pacman314159/Multipurpose_ESP32_Gamepad/imgs/internal assembly (2).png

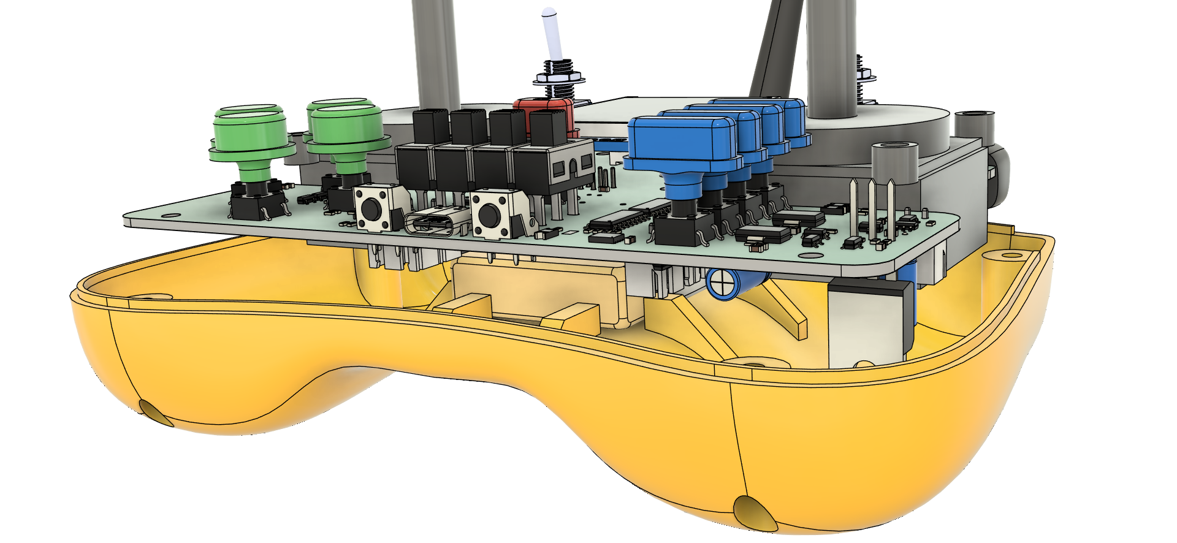
imgs/internal assembly (2).png
