pacman314159/Multipurpose_ESP32_Gamepad/imgs/3d design.png

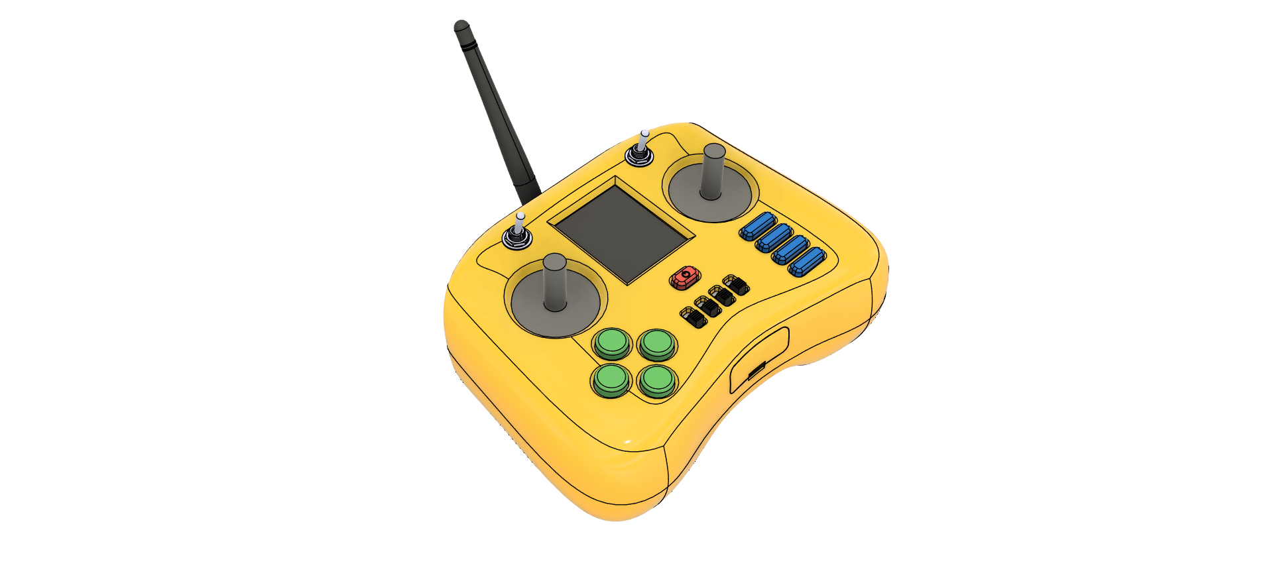
imgs/3d design.png
