pacman314159/Multipurpose_ESP32_Gamepad/imgs/pcb 3d (1).png

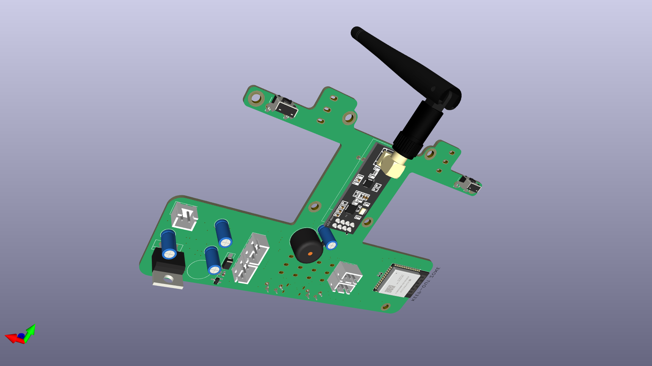
imgs/pcb 3d (1).png
