pacman314159/Multipurpose_ESP32_Gamepad/imgs/pcb 3d.png

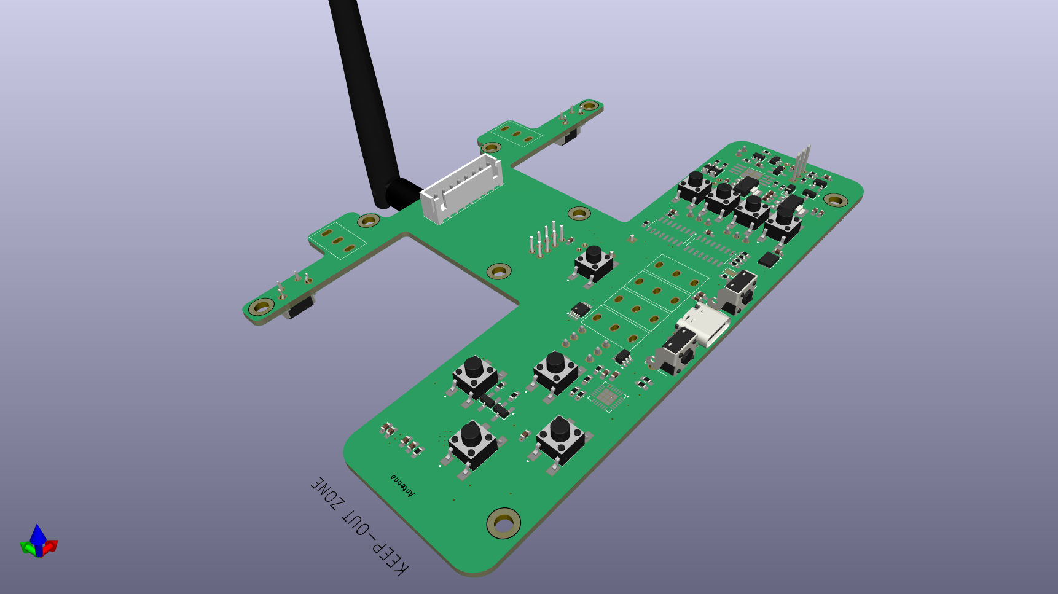
imgs/pcb 3d.png
