pacman314159/Multipurpose_ESP32_Gamepad/imgs/pcb.png

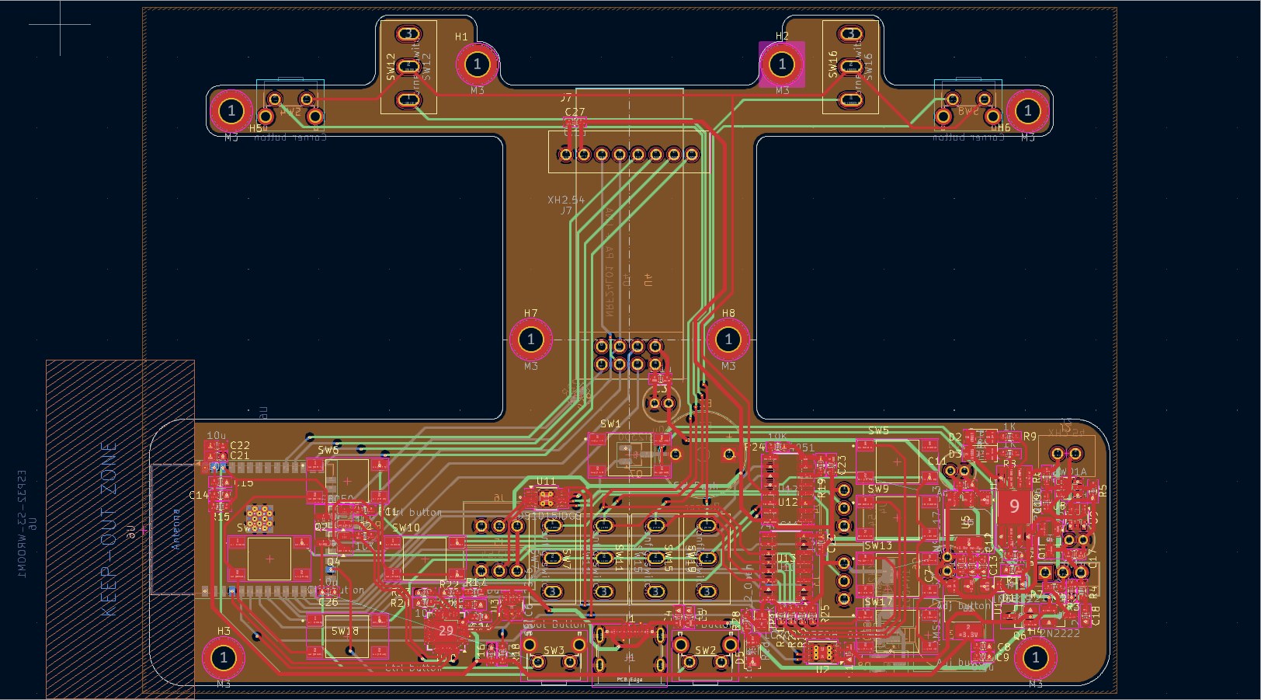
imgs/pcb.png
