pacman314159/Multipurpose_ESP32_Gamepad/imgs/schematic.jpg

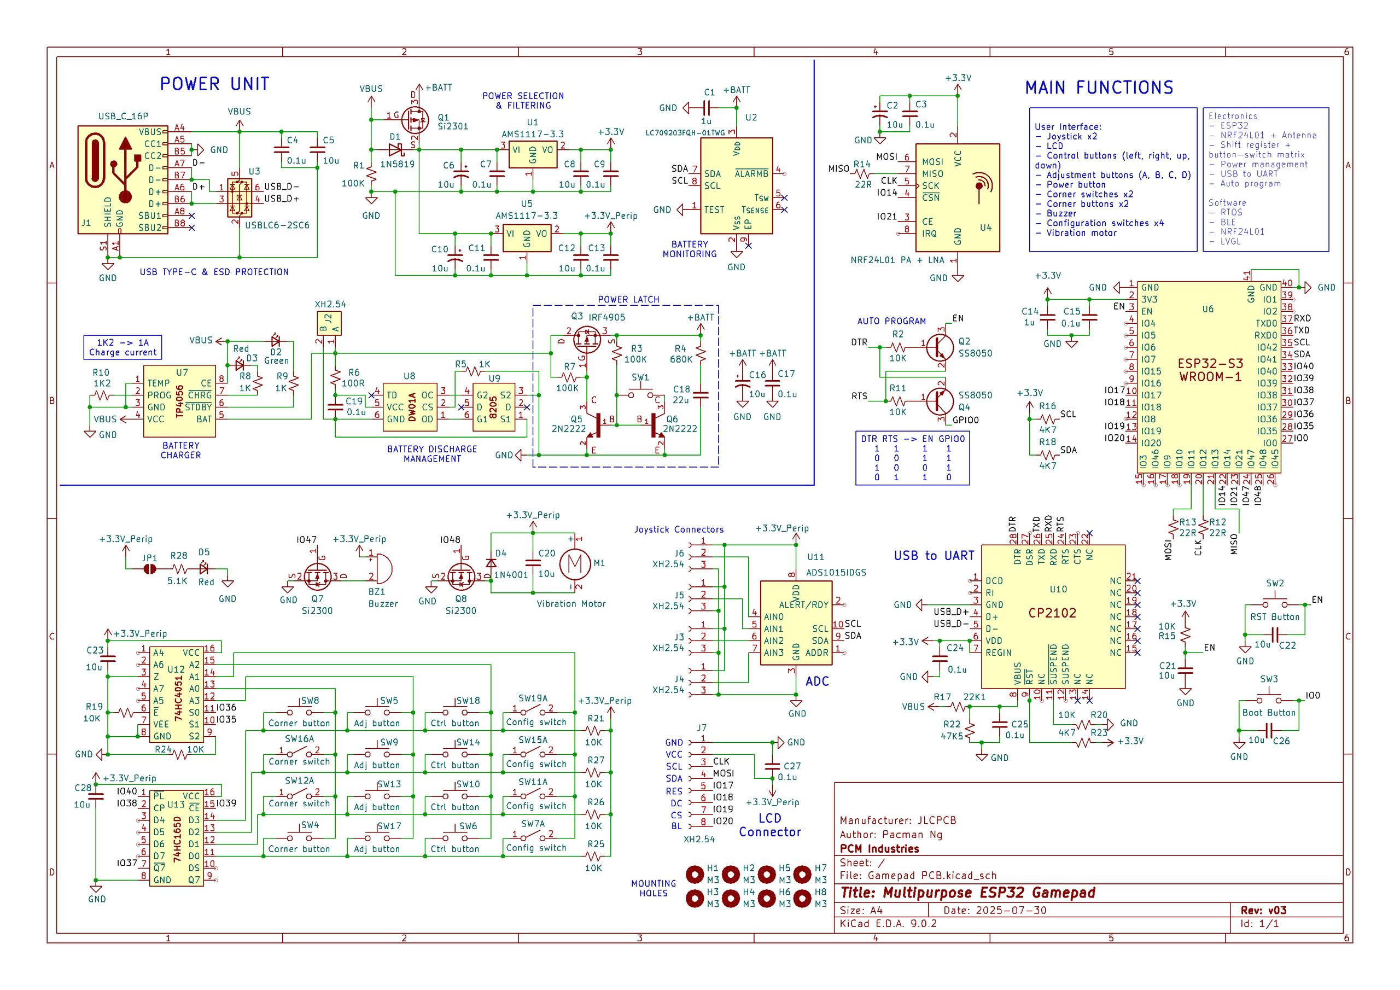
imgs/schematic.jpg
