pacman314159/Multipurpose_ESP32_Gamepad/imgs/schematic_blackwhite.jpg

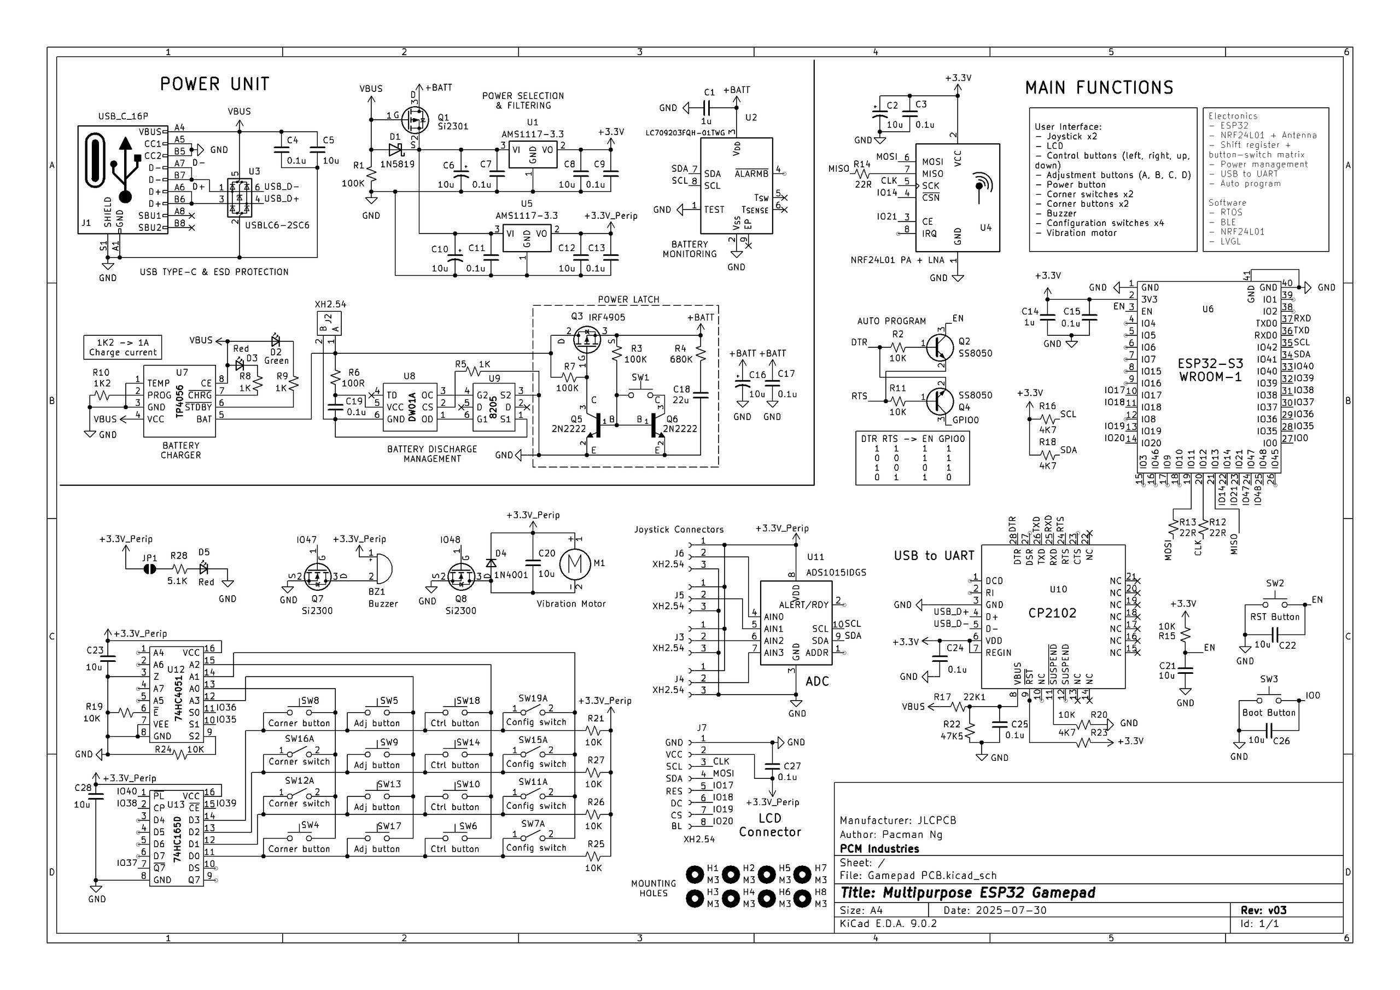
imgs/schematic_blackwhite.jpg
