pacman314159/Multipurpose_ESP32_Gamepad/3d/Case bottom.step

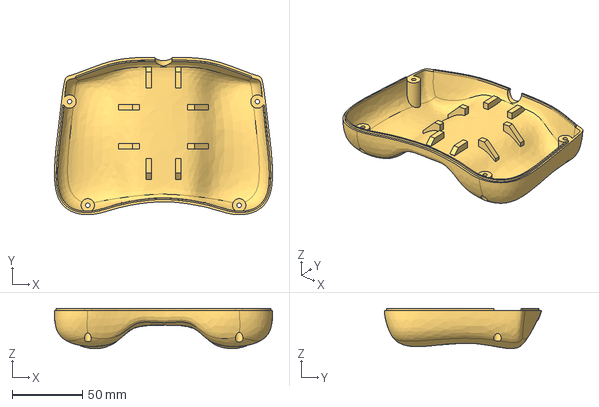
[picture p9: CAD file, 2025-08-13]
3d/Case bottom.step
155.5 x 112.3 x 28.8 mm
