pacman314159/Multipurpose_ESP32_Gamepad/3d/Case top.step

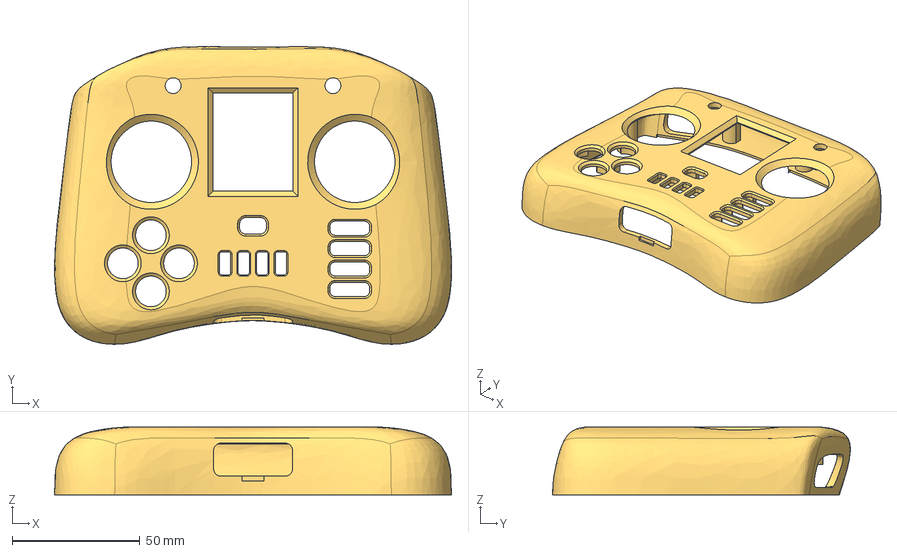
[picture p10: CAD file, 2025-07-30]
3d/Case top.step
155.5 x 116.6 x 26.6 mm
