pacman314159/Multipurpose_ESP32_Gamepad/(list of files, cad)

Other CAD files:
3d/Case top.3mf
