pacman314159/Multipurpose_ESP32_Gamepad/imgs/internal assembly (3).png

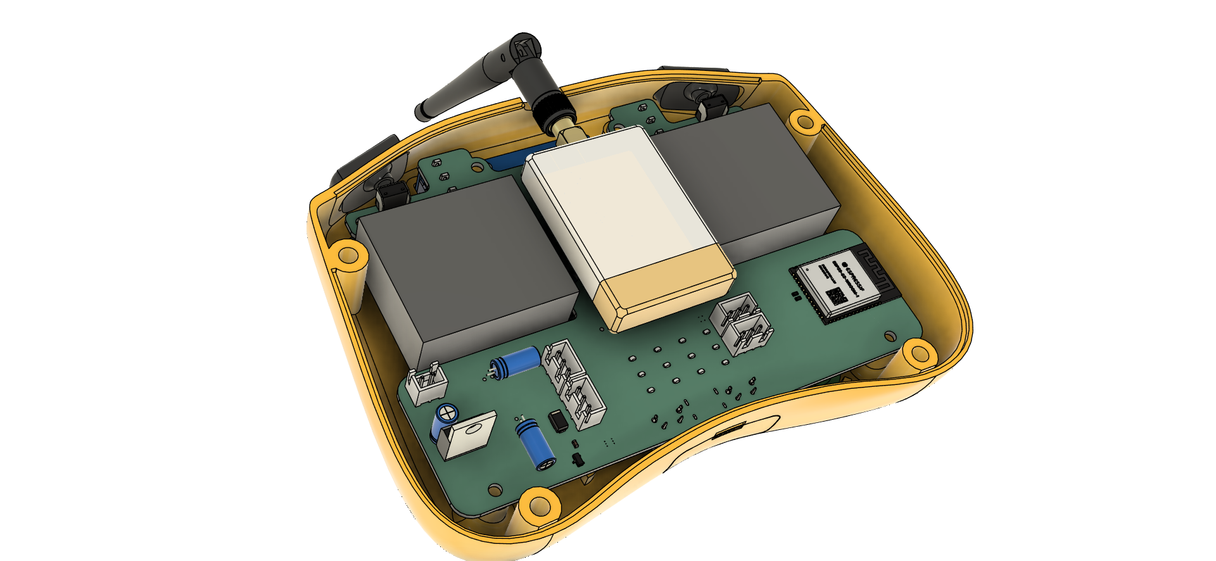
imgs/internal assembly (3).png
