pacman314159/Multipurpose_ESP32_Gamepad/Gamepad PCB/component labelling.pdf

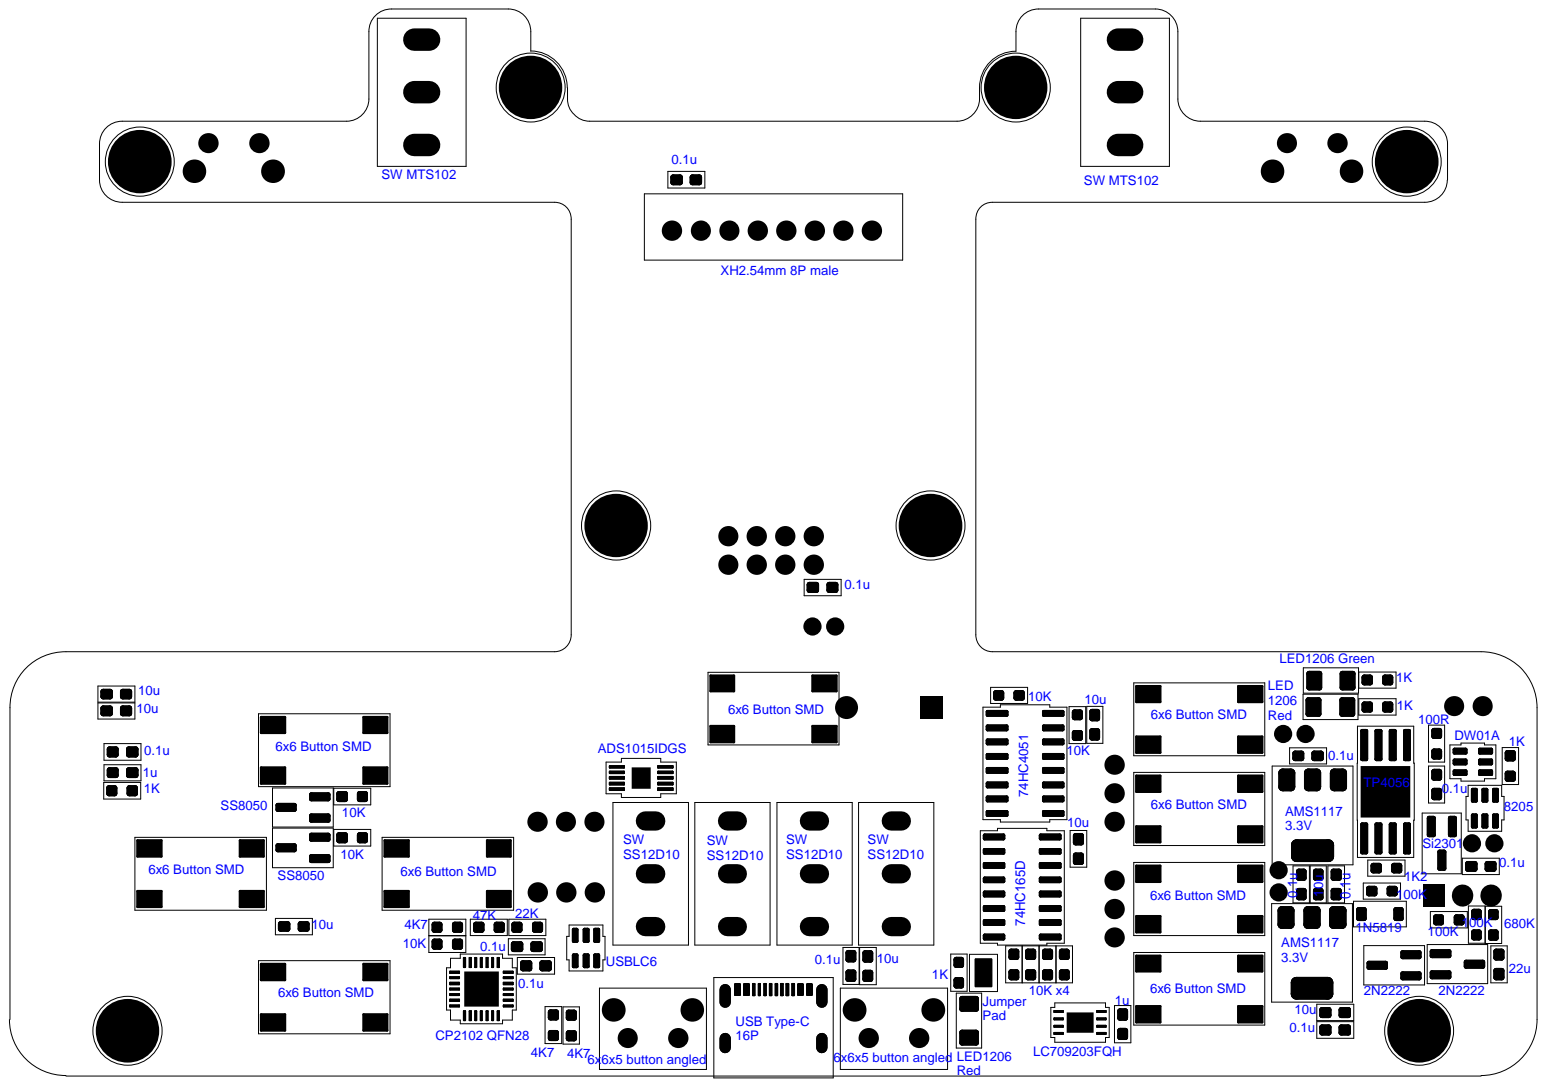
[picture p12: page 1]

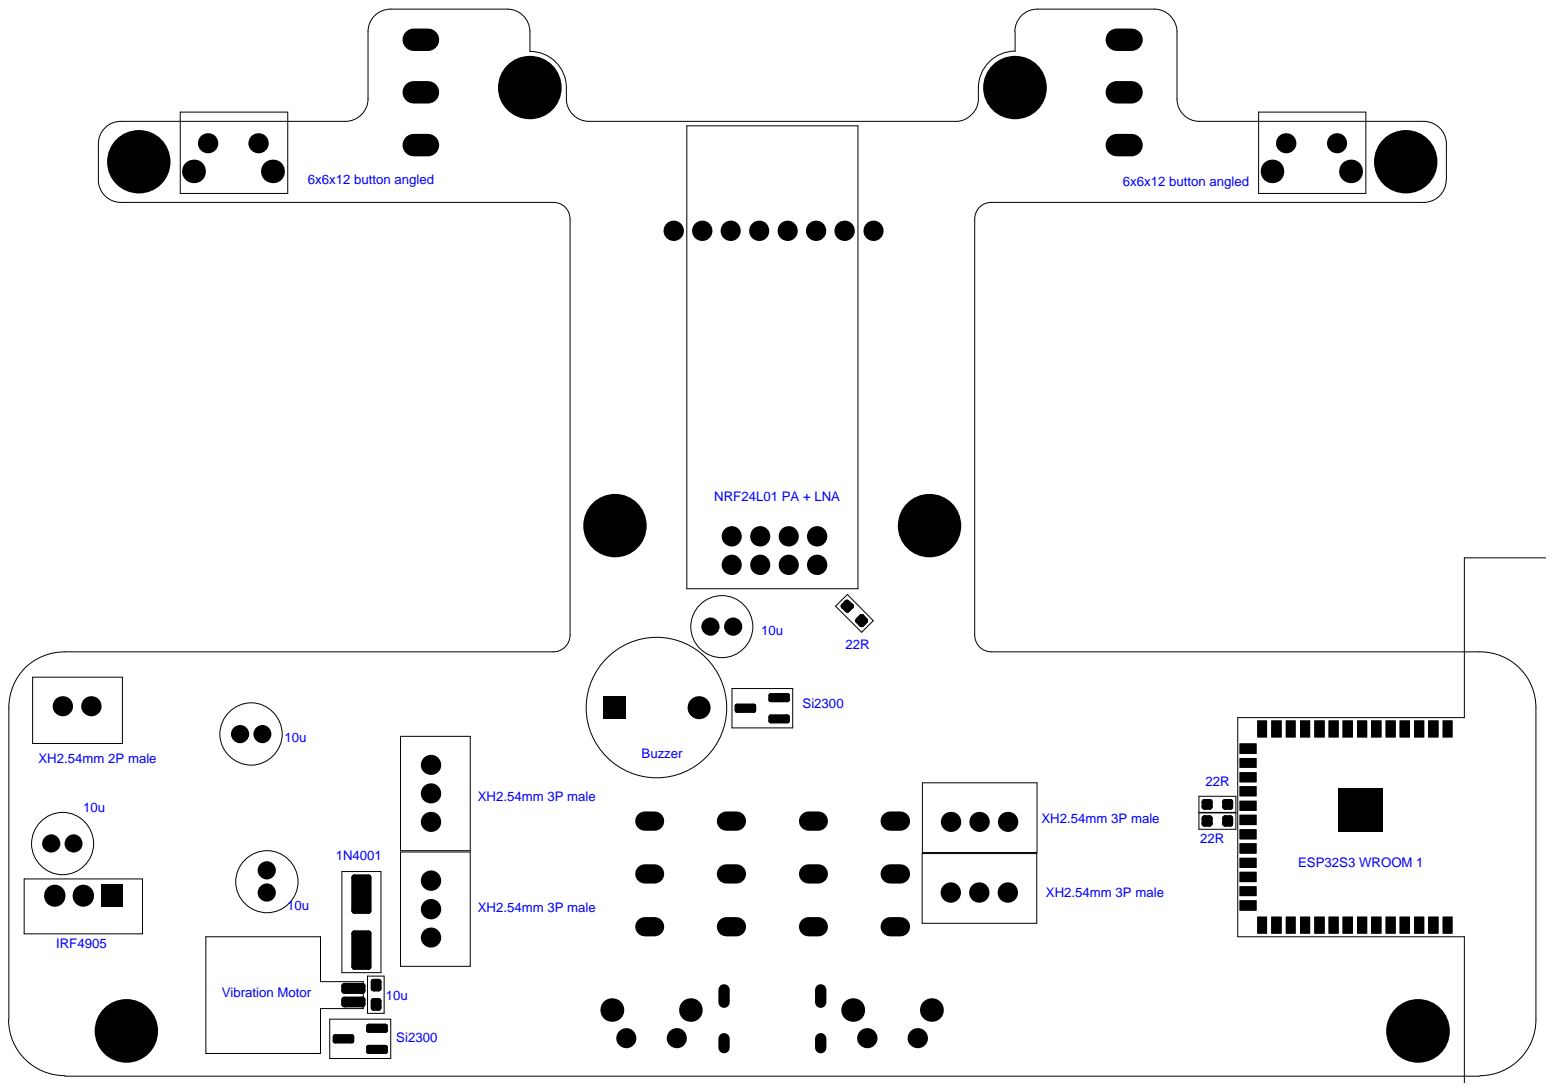
[picture p13: page 2]
