pacman314159/Multipurpose_ESP32_Gamepad/Gamepad PCB/Gamepad PCB.kicad_pcb

## KiCad design Gamepad PCB/Gamepad PCB.kicad_pcb (2025-08-14)

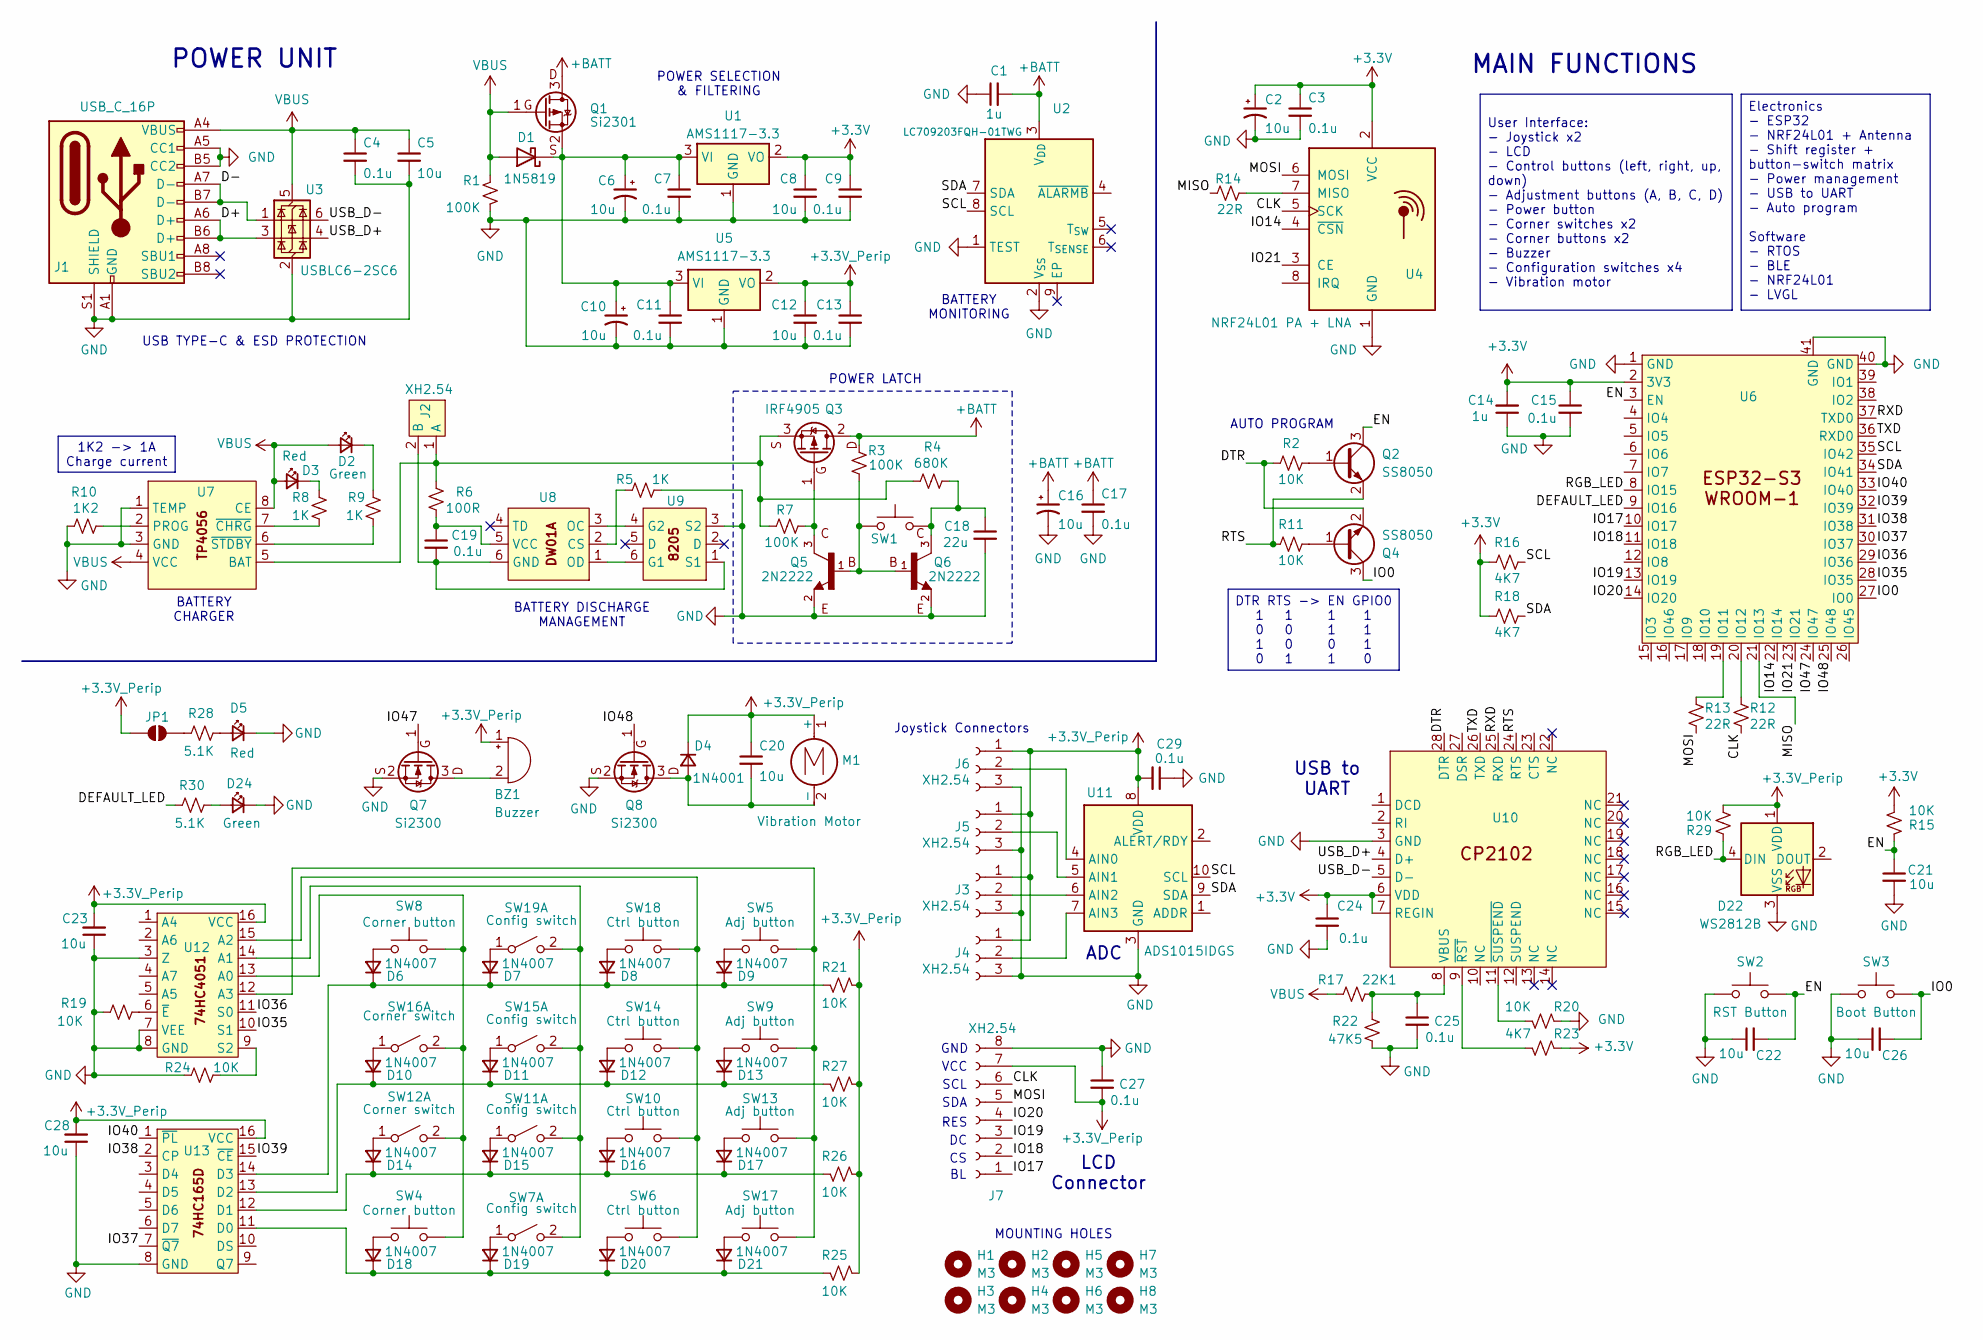
[picture p14: schematic Gamepad PCB.kicad_sch, Multipurpose ESP32 Gamepad]

Parts:
BZ1: Buzzer; Buzzer_12x9.5RM7.6
C1, C14: 1u; C_0603_1608Metric_Pad1.08x0.95mm_HandSolder
C2, C6, C10, C16: 10u; C_Radial_D5.0mm_H11.0mm_P2.00mm
C3, C4, C7, C9, C11, C13, C15, C17, C19, C24, C25, C27, C29: 0.1u; C_0603_1608Metric_Pad1.08x0.95mm_HandSolder
C5, C8, C12, C20, C21, C22, C23, C26, C28: 10u; C_0603_1608Metric_Pad1.08x0.95mm_HandSolder
C18: 22u; C_0603_1608Metric_Pad1.08x0.95mm_HandSolder
D1: 1N5819; D_SOD-123
D2, D24: Green; D_1206_3216Metric_Pad1.42x1.75mm_HandSolder
D3, D5: Red; D_1206_3216Metric_Pad1.42x1.75mm_HandSolder
D4: 1N4001; D_SMA_Handsoldering
D6, D7, D8, D9, D10, D11, D12, D13, D14, D15, D16, D17, D18, D19, D20, D21: 1N4007; D_SOD-123
D22: WS2812B; LED_WS2812B_PLCC4_5.0x5.0mm_P3.2mm
H1, H2, H3, H4, H5, H6, H7, H8: M3; MountingHole_3.2mm_M3_DIN965_Pad_TopBottom
J1: USB_C_16P; USB_C_Receptacle_GCT_USB4105-xx-A_16P_TopMnt_Horizontal
J2: XH2.54; 2P_male
J3, J4, J5, J6: XH2.54; 3P_male
J7: XH2.54; 8P_male
JP1: SolderJumper_2_Open; SolderJumper-2_P1.3mm_Open_TrianglePad1.0x1.5mm
M1: Vibration Motor; XDCR_C0720B001F
Q1: Si2301; SOT-23_Handsoldering
Q2, Q4: SS8050; SOT-23_Handsoldering
Q3: IRF4905; TO-220-3_Vertical
Q5, Q6: 2N2222; SOT-23_Handsoldering; PARTREV January 1989
Q7, Q8: Si2300; SOT-23_Handsoldering
R1, R3, R7: 100K; R_0603_1608Metric_Pad0.98x0.95mm_HandSolder
R2, R11, R15, R19, R20, R21, R24, R25, R26, R27, R29: 10K; R_0603_1608Metric_Pad0.98x0.95mm_HandSolder
R4: 680K; R_0603_1608Metric_Pad0.98x0.95mm_HandSolder
R5, R8, R9: 1K; R_0603_1608Metric_Pad0.98x0.95mm_HandSolder
R6: 100R; R_0603_1608Metric_Pad0.98x0.95mm_HandSolder
R10: 1K2; R_0603_1608Metric_Pad0.98x0.95mm_HandSolder
R12, R13, R14: 22R; R_0603_1608Metric_Pad0.98x0.95mm_HandSolder
R16, R18, R23: 4K7; R_0603_1608Metric_Pad0.98x0.95mm_HandSolder
R17: 22K1; R_0603_1608Metric_Pad0.98x0.95mm_HandSolder
R22: 47K5; R_0603_1608Metric_Pad0.98x0.95mm_HandSolder
R28, R30: 5.1K; R_0603_1608Metric_Pad0.98x0.95mm_HandSolder
SW1: SW_Push; SW_Push_6x6mm_SMD
SW2: RST Button; SW_Tactile_SPST_Angled_PTS645Vx31-2LFS
SW3: Boot Button; SW_Tactile_SPST_Angled_PTS645Vx31-2LFS
SW4, SW8: Corner button; SW_Tactile_SPST_Angled_PTS645Vx31-2LFS
SW5, SW9, SW13, SW17: Adj button; SW_Push_6x6mm_SMD
SW6, SW10, SW14, SW18: Ctrl button; SW_Push_6x6mm_SMD
SW7, SW11, SW15, SW19: Config switch; SS12D10
SW12, SW16: Corner switch; MTS102
U1, U5: AMS1117-3.3; SOT-223-3_TabPin2
U2: LC709203FQH-01TWG; WDFN-8-1EP_4x3mm_P0.65mm_EP2.4x1.8mm_ThermalVias
U3: USBLC6-2SC6; SOT-23-6
U4: NRF24L01 PA + LNA; nRF24L01_PA_LNA
U6: ESP32-S3-WROOM1; esp32s3_wroom_1
U7: TP4056; HTSOP-8-1EP_3.9x4.9mm_P1.27mm_EP2.4x3.2mm_ThermalVias
U8: DW01A; TSOT-23-6
U9: 8205; TSOT-23-6
U10: CP2102; QFN-28-1EP_5x5mm_P0.5mm_EP3.1x3.1mm
U11: ADS1015IDGS; MSOP-10-1EP_3x3mm_P0.5mm_EP1.68x1.88mm_ThermalVias
U12: 74HC4051; SOP-16_3.9x9.9mm_P1.27mm
U13: 74HC165D; SOP-16_3.9x9.9mm_P1.27mm

Connections:
+3.3V: C2.1, C3.1, C8.1, C9.1, C14.2, C15.1, C24.1, R15.2, R16.1, R18.1, R23.1, U1.2 (VO), U4.2 (VCC), U6.2 (3V3), U10.6 (VDD), U10.7 (REGIN)
+3.3V_Perip: BZ1.1 (+), C12.1, C13.1, C20.1, C23.2, C27.2, C28.2, C29.2, D4.1 (K), D22.1 (VDD), J3.1, J4.1, J5.1, J6.1, J7.7, JP1.1 (A), M1.1 (+), R21.1, R25.1, R26.1, R27.1, R29.2, U5.2 (VO), U11.8 (VDD), U12.16 (VCC), U13.16 (VCC)
+BATT: C1.2, C16.1, C17.1, Q1.3, Q3.2, R3.1, U2.3 (V_{DD})
/CLK: J7.6, R12.1, U4.5 (SCK)
/D+: J1.A6 (D+), J1.B6 (D+), U3.3 (I/O2)
/D-: J1.A7 (D-), J1.B7 (D-), U3.1 (I/O1)
/DEFAULT_LED: R30.2, U6.9 (IO16)
/DTR: Q4.2 (E), R2.1, U10.28 (DTR)
/EN: C21.1, C22.2, Q2.3 (C), R15.1, SW2.2, U6.3 (EN)
/IO0: C26.2, Q4.3 (C), SW3.2, U6.27 (IO0)
/IO14: U4.4 (~CSN), U6.22 (IO14)
/IO17: J7.1, U6.10 (IO17)
/IO18: J7.2, U6.11 (IO18)
/IO19: J7.3, U6.13 (IO19)
/IO20: J7.4, U6.14 (IO20)
/IO21: U4.3 (CE), U6.23 (IO21)
/IO35: U6.28 (IO35), U12.10 (S1)
/IO36: U6.29 (IO36), U12.11 (S0)
/IO37: U6.30 (IO37), U13.7 (~Q7)
/IO38: U6.31 (IO38), U13.2 (CP)
/IO39: U6.32 (IO39), U13.15 (~CE)
/IO40: U6.33 (IO40), U13.1 (~PL)
/IO47: Q7.1, U6.24 (IO47)
/IO48: Q8.1, U6.25 (IO48)
/MISO: R14.1, U6.21 (IO13)
/MOSI: J7.5, R13.1, U4.6 (MOSI)
/RGB_LED: D22.4 (DIN), R29.1, U6.8 (IO15)
/RTS: Q2.2 (E), R11.1, U10.24 (RTS)
/RXD: U6.37 (TXD0), U10.25 (RXD)
/SCL: R16.2, U2.8 (SCL), U6.35 (IO42), U11.10 (SCL)
/SDA: R18.2, U2.7 (SDA), U6.34 (IO41), U11.9 (SDA)
/TXD: U6.36 (RXD0), U10.26 (TXD)
/USB_D+: U3.4 (I/O2), U10.4 (D+)
/USB_D-: U3.6 (I/O1), U10.5 (D-)
GND: C1.1, C2.2, C3.2, C4.2, C5.2, C6.2, C7.2, C8.2, C9.2, C10.2, C11.2, C12.2, C13.2, C14.1, C15.2, C16.2, C17.2, C18.2, C21.2, C22.1, C23.1, C24.2, C25.2, C26.1, C27.1, C28.1, C29.1, D5.1 (K), D22.3 (VSS), D24.1 (K), J1.A1 (GND), J1.A5 (CC1), J1.A12 (GND), J1.B1 (GND), J1.B5 (CC2), J1.B12 (GND), J1.S1 (SHIELD), J3.3, J4.3, J5.3, J6.3, J7.8, Q5.2, Q6.2, Q7.2, Q8.2, R1.2, R5.2, R10.1, R19.2, R20.1, R22.1, R24.1, SW2.1, SW3.1, U1.1 (GND), U2.1 (TEST), U2.2 (V_{SS}), U3.2 (GND), U4.1 (GND), U5.1 (GND), U6.1 (GND), U6.40 (GND), U6.41 (GND), U7.1 (TEMP), U7.3 (GND), U9.3 (S2), U10.3 (GND), U11.3 (GND), U12.3 (Z), U12.7 (VEE), U12.8 (GND), U13.8 (GND)
unnamed: BZ1.2 (-), Q7.3
unnamed: C18.1, Q6.3, R4.2, SW1.2
unnamed: C6.1, C7.1, C10.1, C11.1, D1.1 (K), Q1.2, U1.3 (VI), U5.3 (VI)
unnamed: D2.1 (K), R9.2
unnamed: D3.1 (K), R8.2
unnamed: C20.2, D4.2 (A), M1.2 (-), Q8.3
unnamed: D5.2 (A), R28.1
unnamed: D6.2 (A), SW8.1
unnamed: D6.1 (K), D7.1 (K), D8.1 (K), D9.1 (K), R21.2, U13.14 (D3)
unnamed: D7.2 (A), SW19.1 (A)
unnamed: D8.2 (A), SW18.1
unnamed: D9.2 (A), SW5.1
unnamed: D10.2 (A), SW16.1 (A)
unnamed: D10.1 (K), D11.1 (K), D12.1 (K), D13.1 (K), R27.2, U13.13 (D2)
unnamed: D11.2 (A), SW15.1 (A)
unnamed: D12.2 (A), SW14.1
unnamed: D13.2 (A), SW9.1
unnamed: D14.2 (A), SW12.1 (A)
unnamed: D14.1 (K), D15.1 (K), D16.1 (K), D17.1 (K), R26.2, U13.12 (D1)
unnamed: D15.2 (A), SW11.1 (A)
unnamed: D16.2 (A), SW10.1
unnamed: D17.2 (A), SW13.1
unnamed: D18.2 (A), SW4.2
unnamed: D18.1 (K), D19.1 (K), D20.1 (K), D21.1 (K), R25.2, U13.11 (D0)
unnamed: D19.2 (A), SW7.1 (A)
unnamed: D20.2 (A), SW6.1
unnamed: D21.2 (A), SW17.1
unnamed: D24.2 (A), R30.1
unnamed: J2.1 (A), Q3.3, R4.1, R6.2, R7.2, U7.5 (BAT)
unnamed: C19.2, J2.2 (B), U8.6 (GND), U9.1 (S1)
unnamed: J3.2, U11.6 (AIN2)
unnamed: J4.2, U11.7 (AIN3)
unnamed: J5.2, U11.5 (AIN1)
unnamed: J6.2, U11.4 (AIN0)
unnamed: JP1.2 (B), R28.2
unnamed: Q2.1 (B), R2.2
unnamed: Q3.1, Q5.3, R7.1
unnamed: Q4.1 (B), R11.2
unnamed: Q5.1, Q6.1, R3.2, SW1.1
unnamed: SW7.2 (B), SW11.2 (B), SW15.2 (B), SW19.2 (B), U12.14 (A1)
unnamed: SW4.1, SW8.2, SW12.2 (B), SW16.2 (B), U12.13 (A0)
unnamed: R14.2, U4.7 (MISO)
unnamed: R13.2, U6.19 (IO11)
unnamed: R12.2, U6.20 (IO12)
unnamed: R10.2, U7.2 (PROG)
unnamed: R8.1, U7.7 (~CHRG)
unnamed: R9.1, U7.6 (~STDBY)
unnamed: R5.1, U8.2 (CS)
unnamed: U8.3 (OC), U9.4 (G2)
unnamed: U8.1 (OD), U9.6 (G1)
unnamed: C19.1, R6.1, U8.5 (VCC)
unnamed: C25.1, R17.2, R22.2, U10.8 (VBUS)
unnamed: R23.2, U10.9 (~RST)
unnamed: R20.2, U10.11 (~SUSPEND)
unnamed: SW6.2, SW10.2, SW14.2, SW18.2, U12.15 (A2)
unnamed: SW5.2, SW9.2, SW13.2, SW17.2, U12.12 (A3)
unnamed: R24.2, U12.9 (S2)
unnamed: R19.1, U12.6 (~E)
VBUS: C4.1, C5.1, D1.2 (A), D2.2 (A), D3.2 (A), J1.A4 (VBUS), J1.A9 (VBUS), J1.B4 (VBUS), J1.B9 (VBUS), Q1.1, R1.1, R17.1, U3.5 (VBUS), U7.4 (VCC), U7.8 (CE)

Notes on the sheet:
MAIN FUNCTIONS
POWER UNIT
BATTERY DISCHARGE MANAGEMENT
BATTERY CHARGER
USB to UART
BATTERY MONITORING
LCD Connector
RES
MOUNTING HOLES
ADC
VCC
POWER SELECTION & FILTERING
AUTO PROGRAM
SDA
USB TYPE-C & ESD PROTECTION
POWER LATCH
GND
Joystick Connectors
SCL
DTR RTS -> EN GPIO0 1 1 1 1 0 0 1 1 1 0 0 1 0 1 1 0
1K2 -> 1A Charge current
Electronics - ESP32 - NRF24L01 + Antenna - Shift register + button-switch matrix - Power management - USB to UART - Auto program Software - RTOS - BLE - NRF24L01 - LVGL
User Interface: - Joystick x2 - LCD - Control buttons (left, right, up, down) - Adjustment buttons (A, B, C, D) - Power button - Corner switches x2 - Corner buttons x2 - Buzzer - Configuration switches x4 - Vibration motor

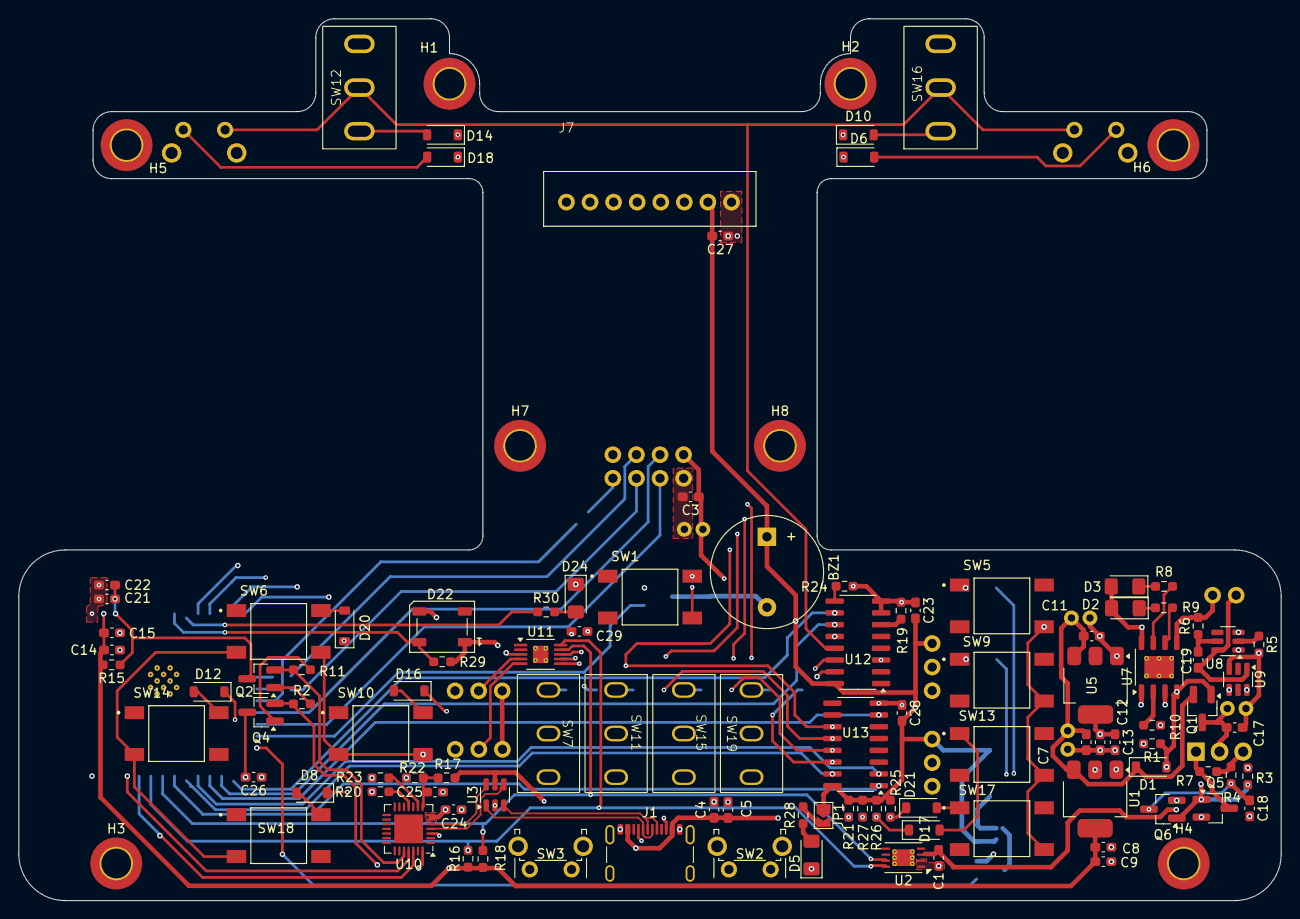
[picture p15: board Gamepad PCB.kicad_pcb from above]

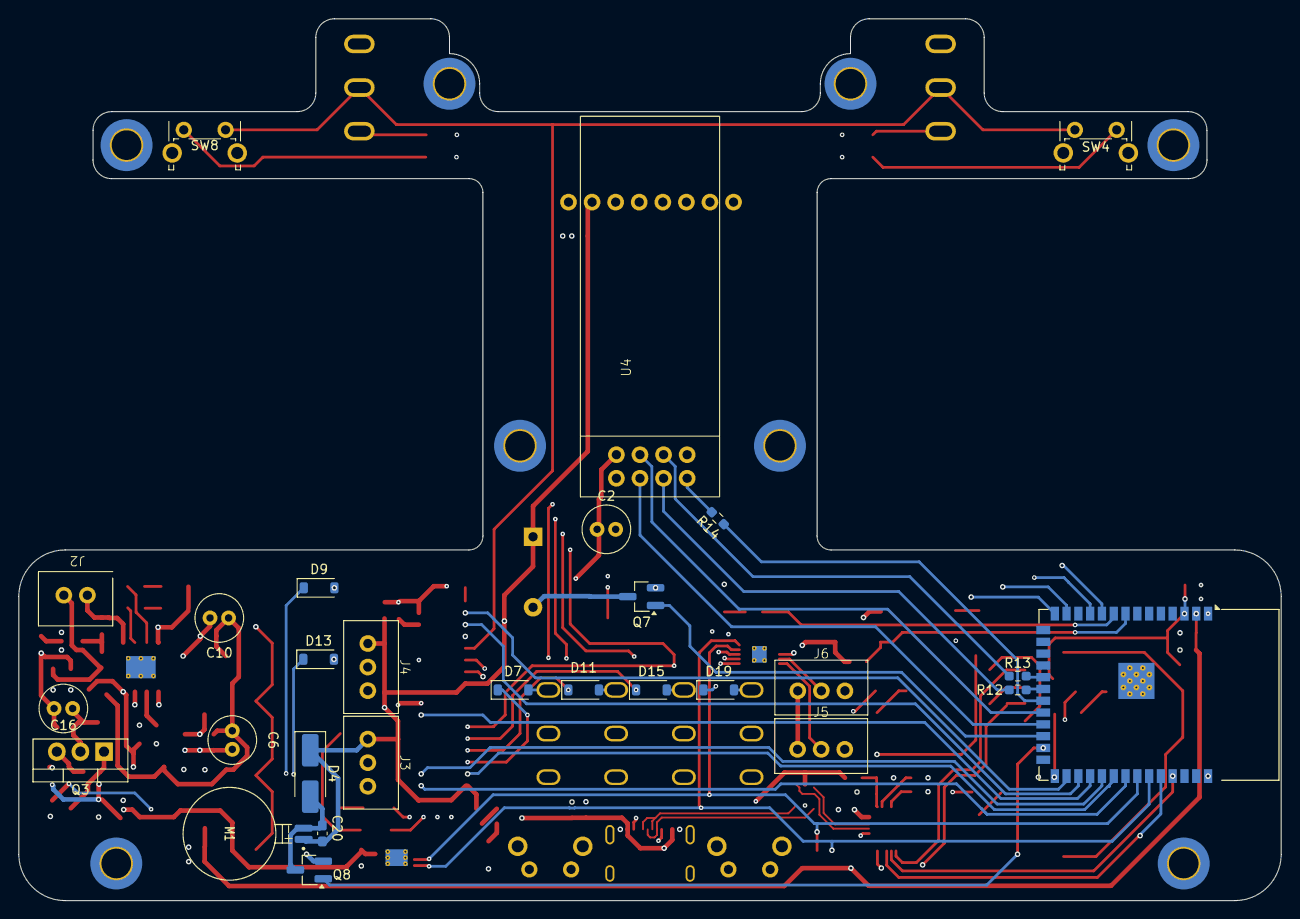
[picture p16: board Gamepad PCB.kicad_pcb from below]

Board: 4 copper layers, 136.0 x 95.0 mm, 140 parts (28 on the bottom side), 94 nets.
