pacman314159/Multipurpose_ESP32_Gamepad/firmware/src/tasks/task_manager.h

#ifndef TASKS_COMMON_H
#define TASKS_COMMON_H

#include <freertos/FreeRTOS.h>
#include <freertos/task.h>

#include "hardware/hardware_manager.h"

void lvgl_background_task(void *pvParameters);
void joystick_raw_reading_task(void *pvParameters);

#endif
