pacman314159/Multipurpose_ESP32_Gamepad/(commit log)

2025-07-30 add imgs
    [Gamepad PCB.kicad_sch]
2025-08-07 fix Q3, R14, C18 schematic
    [User_Setup.h, hardware_config.h, hardware_manager.cpp, hardware_manager.h, joystick_tasks.cpp, joysticks.cpp, joysticks.h]
2025-08-13 fix entire pcb
    [Case bottom.step, Case top.3mf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]
2025-08-14 add pcb interface
    [Gamepad PCB-B_Cu.gbr, Gamepad PCB-B_Mask.gbr, Gamepad PCB-B_Paste.gbr, Gamepad PCB-B_Silkscreen.gbr, Gamepad PCB-Edge_Cuts.gbr, Gamepad PCB-F_Cu.gbr, Gamepad PCB-F_Mask.gbr, Gamepad PCB-F_Paste.gbr]
